S9-Engineering/boreo-superkikko2-torch-mount/LICENSING.md

# S9 Engineering project licensing

Original project designs and documentation are licensed under **Creative Commons Attribution-NonCommercial-ShareAlike 4.0 International (CC BY-NC-SA 4.0)**, to the extent the licensor holds the relevant copyright and similar rights. Original S9 software is separately licensed under **PolyForm Noncommercial License 1.0.0**. This notice identifies the covered material; it does not modify either license. Read the [design/documentation license](LICENSE.txt), its [official summary](https://creativecommons.org/licenses/by-nc-sa/4.0/) and the [software license](LICENSE-SOFTWARE.txt).

## Covered material and attribution

The grant covers original mechanical designs, native CAD documents, design parameters, STEP/STL geometry, the original design content in printable 3MF/G-code, instructions, diagrams and illustrations, unless separately marked. It includes retained revisions and copies of those materials in project release packages. It does not relicense slicer software, profiles or third-party content embedded in these formats. AI-generated illustrations are covered only to the extent the licensor holds applicable rights.

When sharing, credit **S9 Engineering**, link to the source project and license, retain applicable notices and identify changes. Follow the full license for the precise obligations. Suggested credit:

> Based on a design by S9 Engineering — CC BY-NC-SA 4.0. Source: [project repository URL]. Changes: [description, if modified].

Noncommercial copying, printing, adaptation and sharing are permitted within the licensed rights. Shared adaptations must satisfy Section 3(b)'s ShareAlike terms. Private modifications do not have to be published; ShareAlike does not itself require editable CAD source distribution.

## Commercial permissions

The CC BY-NC-SA public license does not grant commercial-use permissions for the designs and documentation. For commercial uses requiring permission under the licensed rights, including selling copies of protected files or protected designs as printed products, contact S9 Engineering for a separate written authorization. No merchant permission, price or automatic approval is granted here.

NonCommercial means not primarily intended for or directed towards commercial advantage or monetary compensation; it is not simply a distinction between individuals and companies. Ask the project maintainer about uncertain uses. This notice adds no restrictions to uses already permitted by the CC license or applicable law.

## S9 names and logos

Standalone S9 / S9 Engineering logo artwork and trademark rights are excluded from the general CC grant. You may retain and reproduce S9 branding already incorporated in a project model or its documentation when printing or sharing that project for permitted noncommercial purposes. Factual attribution and uses allowed by law remain permitted. Other branding uses require separate permission. Do not imply that S9 manufactures, certifies or endorses your copy or adaptation. This branding permission grants no commercial rights or trademark ownership.

## Software and third-party material

Original S9 software files, including executable CAD generators, build/render scripts and project tools, are licensed under **PolyForm Noncommercial License 1.0.0**, including retained original versions, unless a file is separately marked. Read [LICENSE-SOFTWARE.txt](LICENSE-SOFTWARE.txt) for the complete, unmodified terms. These software files are excluded from the CC grant above.

Required Notice: S9 Engineering (https://github.com/S9-Engineering)

When redistributing covered software, include the PolyForm terms or their official URL and retain the Required Notice above and other applicable required notices. The license permits use, modifications and redistribution for its permitted purposes. These include noncommercial and specified personal uses, plus use by the organizations expressly listed in the license, including educational institutions, public research and government institutions, regardless of their funding. Obtain separate permission for software uses outside the public grant; do not treat every professional or institutional use as automatically requiring payment. PolyForm does not impose a requirement to publish modified source code. The software is source-available, not OSI open-source software.

The software license does not automatically determine the license of generated files. Original S9 design content in generated models remains under CC BY-NC-SA 4.0 to the extent covered by the licensed rights. A user's unrelated original output is not automatically relicensed by running a S9 tool.

Third-party software, models, photographs, fonts, libraries, profiles and other assets retain their own rights and notices; they are not relicensed under these S9 defaults. Manufacturer names identify compatibility and do not imply affiliation. This notice grants no rights the licensor does not hold.

## Scope and existing releases

The CC license covers applicable copyright and similar rights only. It creates no rights in purely functional features or public-domain material and licenses no patents or third-party trademarks. It does not guarantee an exclusive right to manufacture a functional object. The software license includes only the patent grant stated in its own terms. With its noncommercial restriction, the project is not offered as open-source hardware under the OSHWA definition.

CC permissions remain available to recipients who comply with their terms. Published archives, tags and checksums are not rewritten when this notice is introduced. Earlier archive instructions saying no license was selected, or that software terms were undecided, describe the position at publication; this notice now grants the stated design/documentation and software rights in covered original material, including copies in those earlier releases. Retain applicable notices and license information when redistributing as required by the respective license. New S9 release packages carry this notice, LICENSE.txt and LICENSE-SOFTWARE.txt.

Separate commercial licensing of other authors' contributions requires their necessary permissions; this notice does not assign their rights to S9 Engineering.
