S9-Engineering/boreo-superkikko2-torch-mount/previews/renders/hero-ai.png

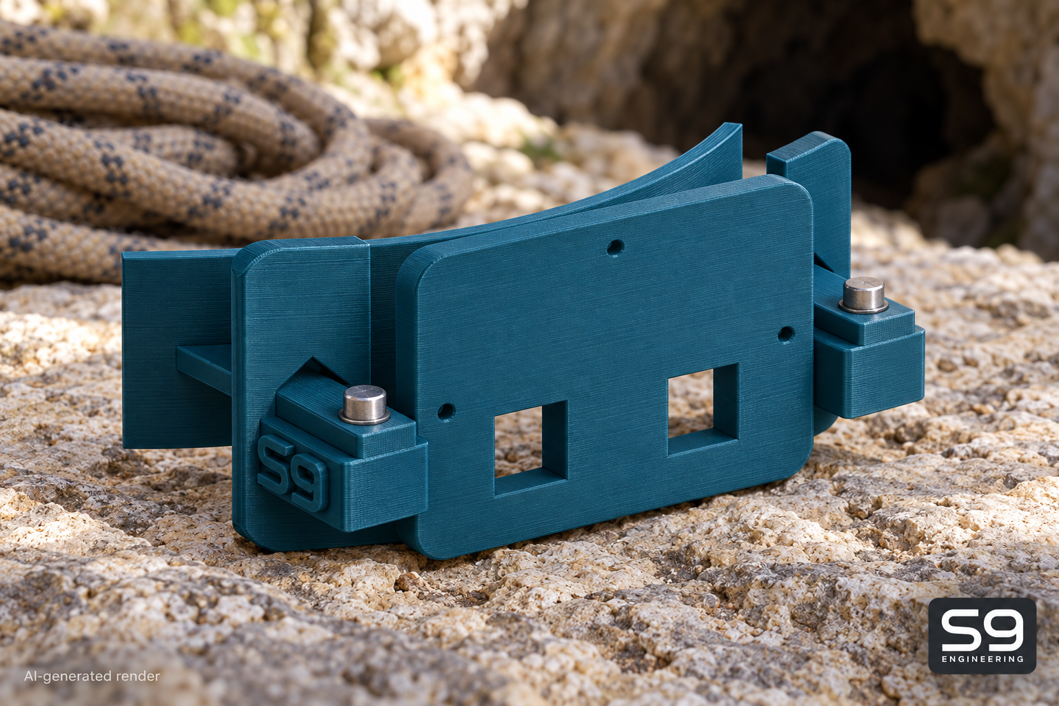
previews/renders/hero-ai.png
