S9-Engineering/boreo-superkikko2-torch-mount/previews/slicing/detail-1.png

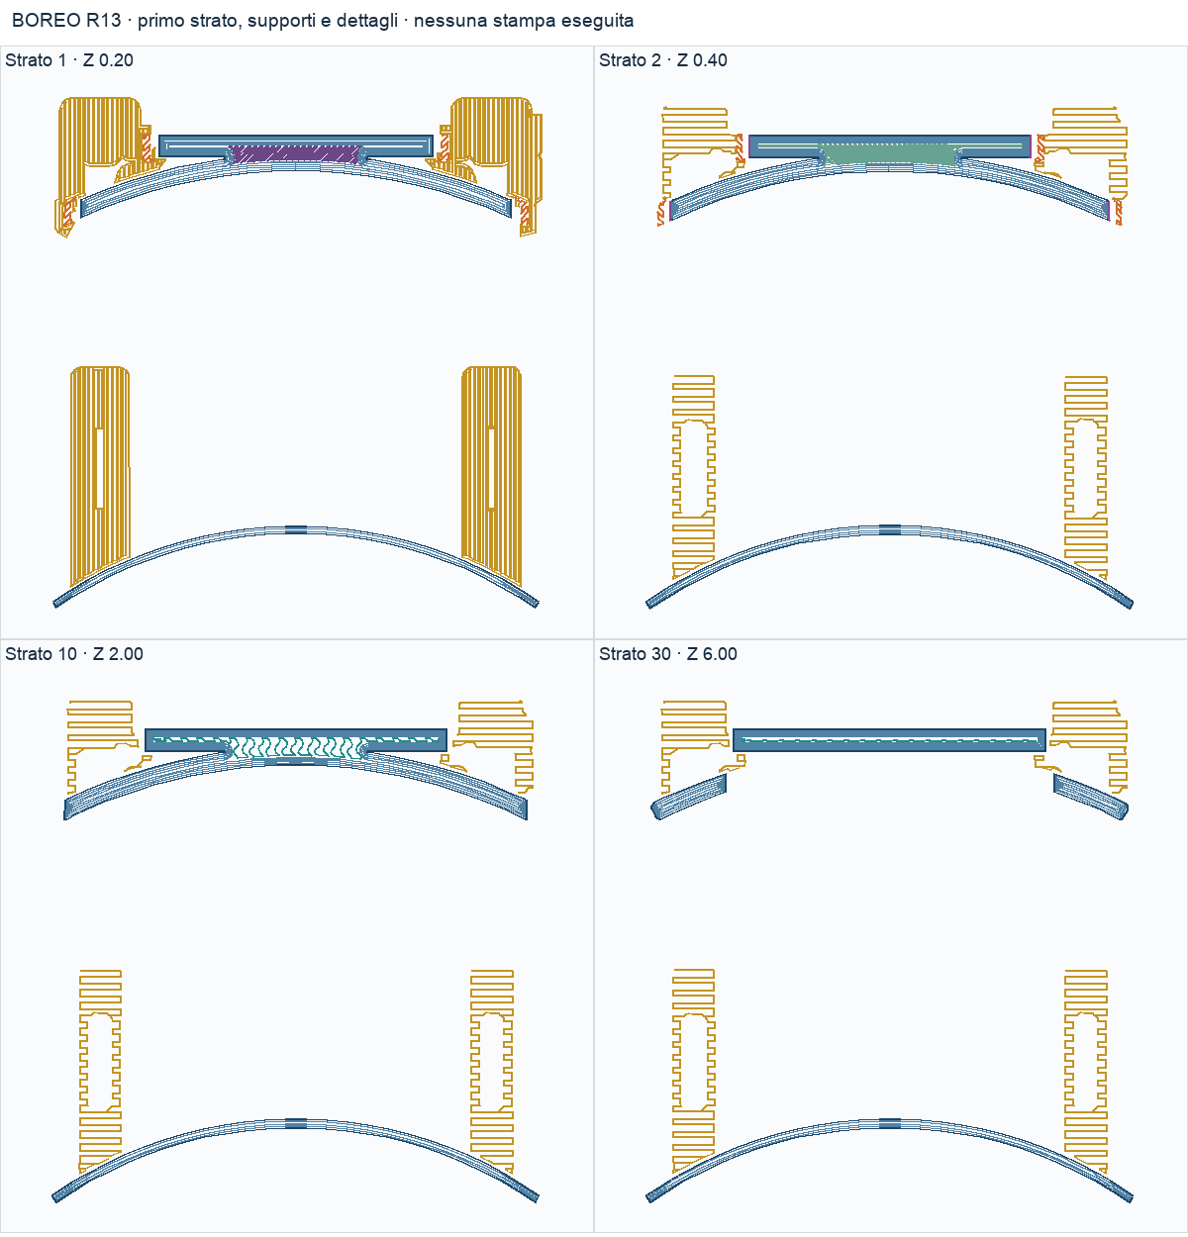
previews/slicing/detail-1.png
