S9-Engineering/boreo-superkikko2-torch-mount/previews/slicing/detail-2.png

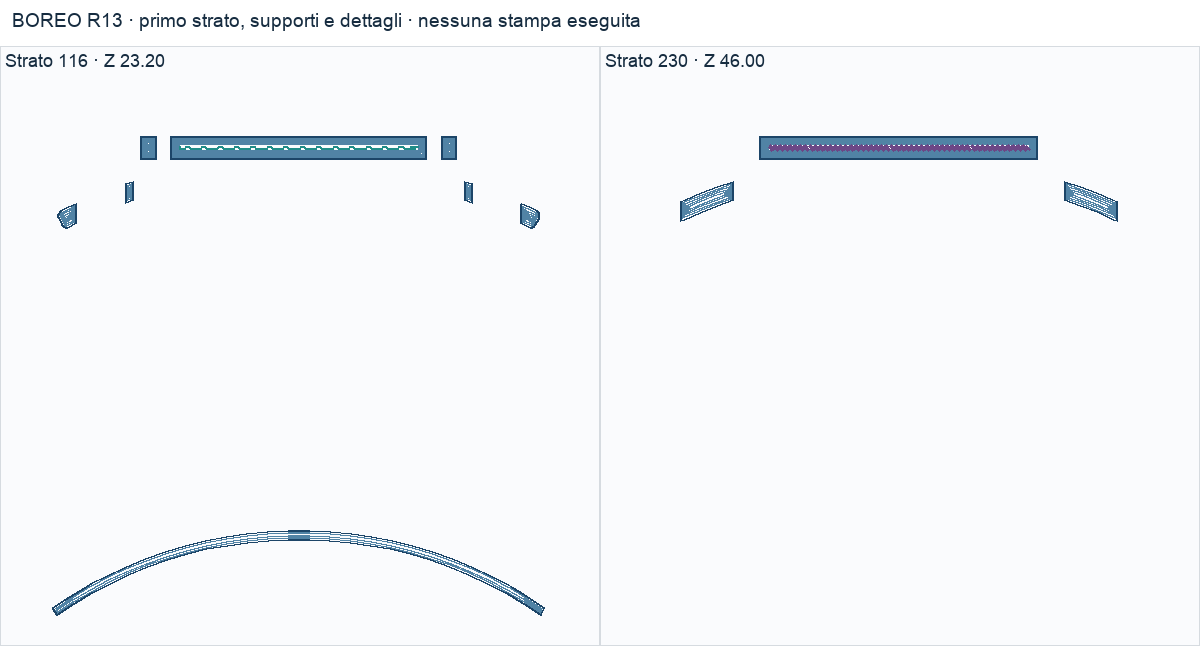
previews/slicing/detail-2.png
