S9-Engineering/boreo-superkikko2-torch-mount/previews/slicing/layers-0001_0064.png

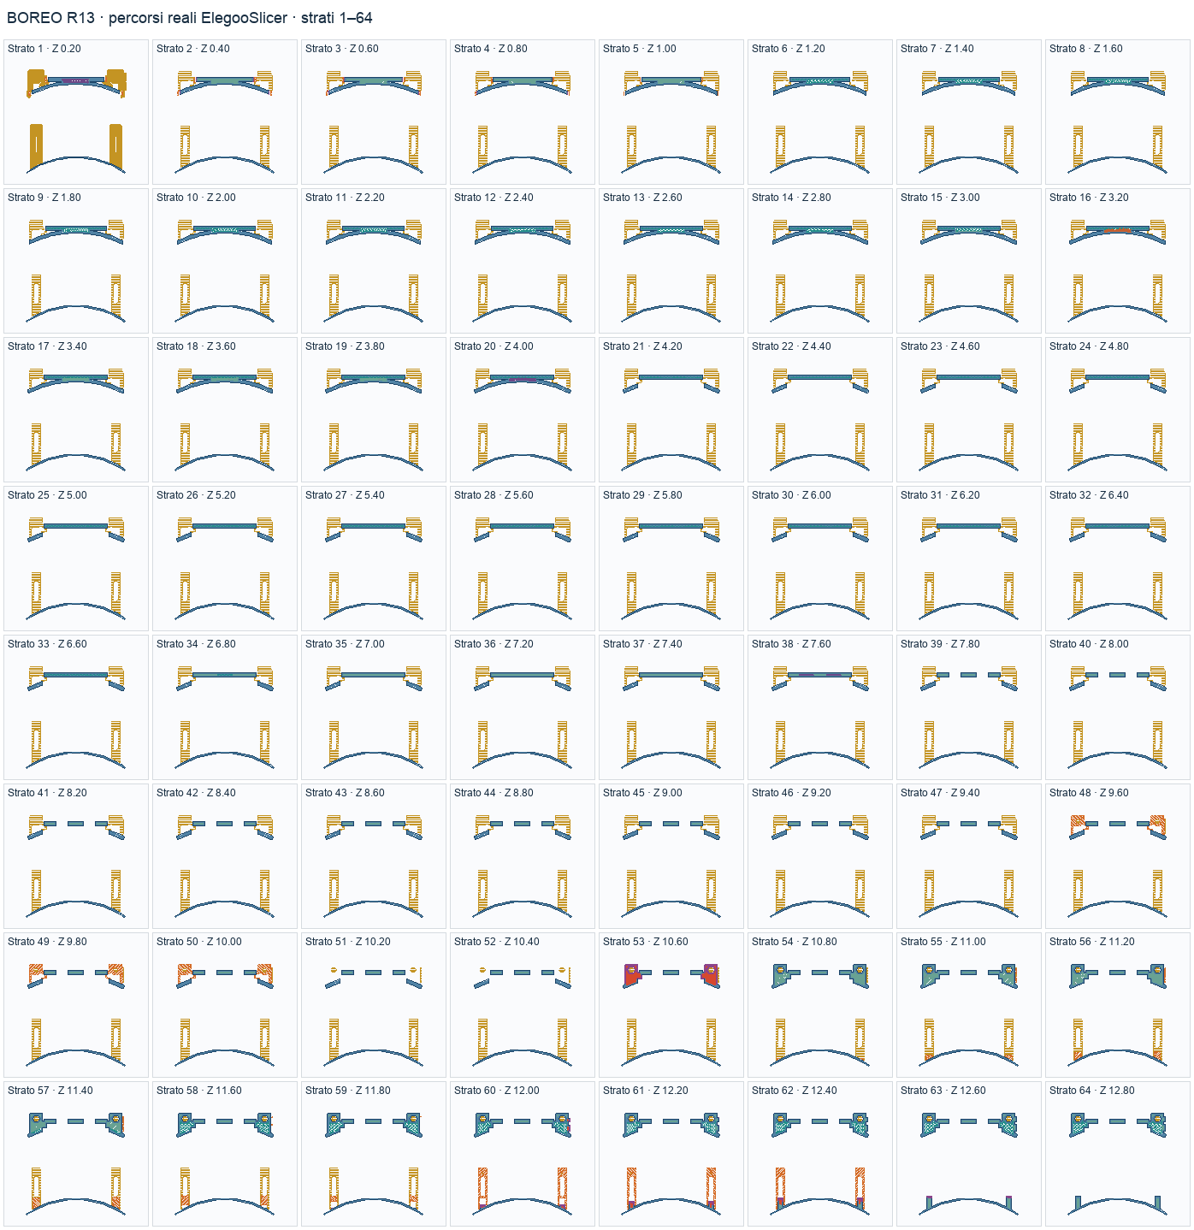
previews/slicing/layers-0001_0064.png
