S9-Engineering/boreo-superkikko2-torch-mount/previews/slicing/layers-0065_0128.png

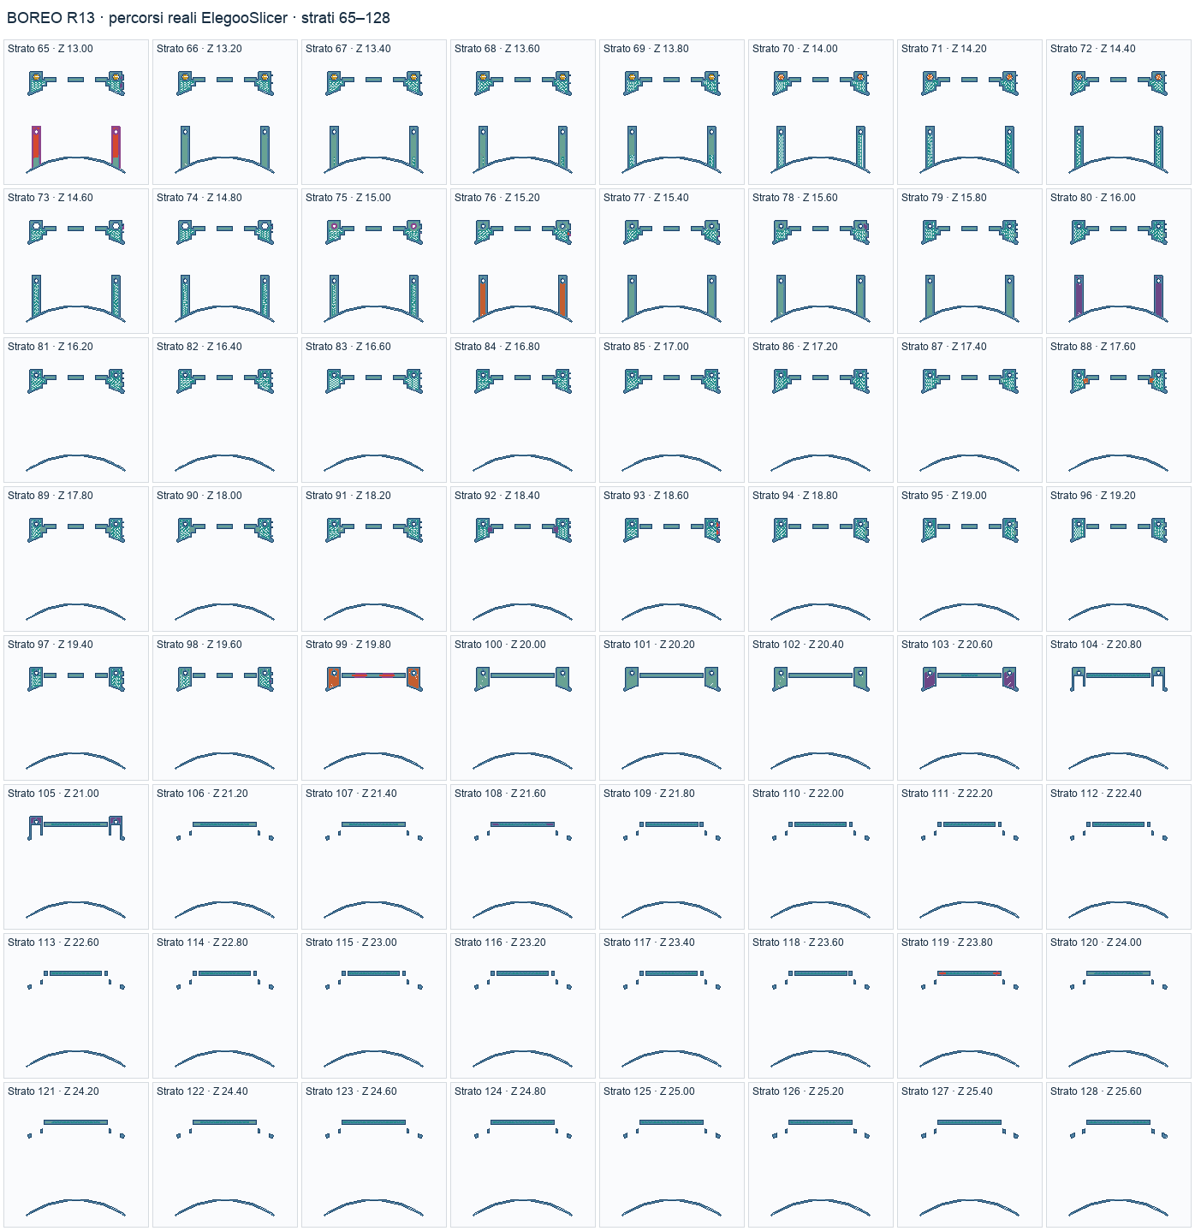
previews/slicing/layers-0065_0128.png
