S9-Engineering/boreo-superkikko2-torch-mount/previews/slicing/layers-0129_0192.png

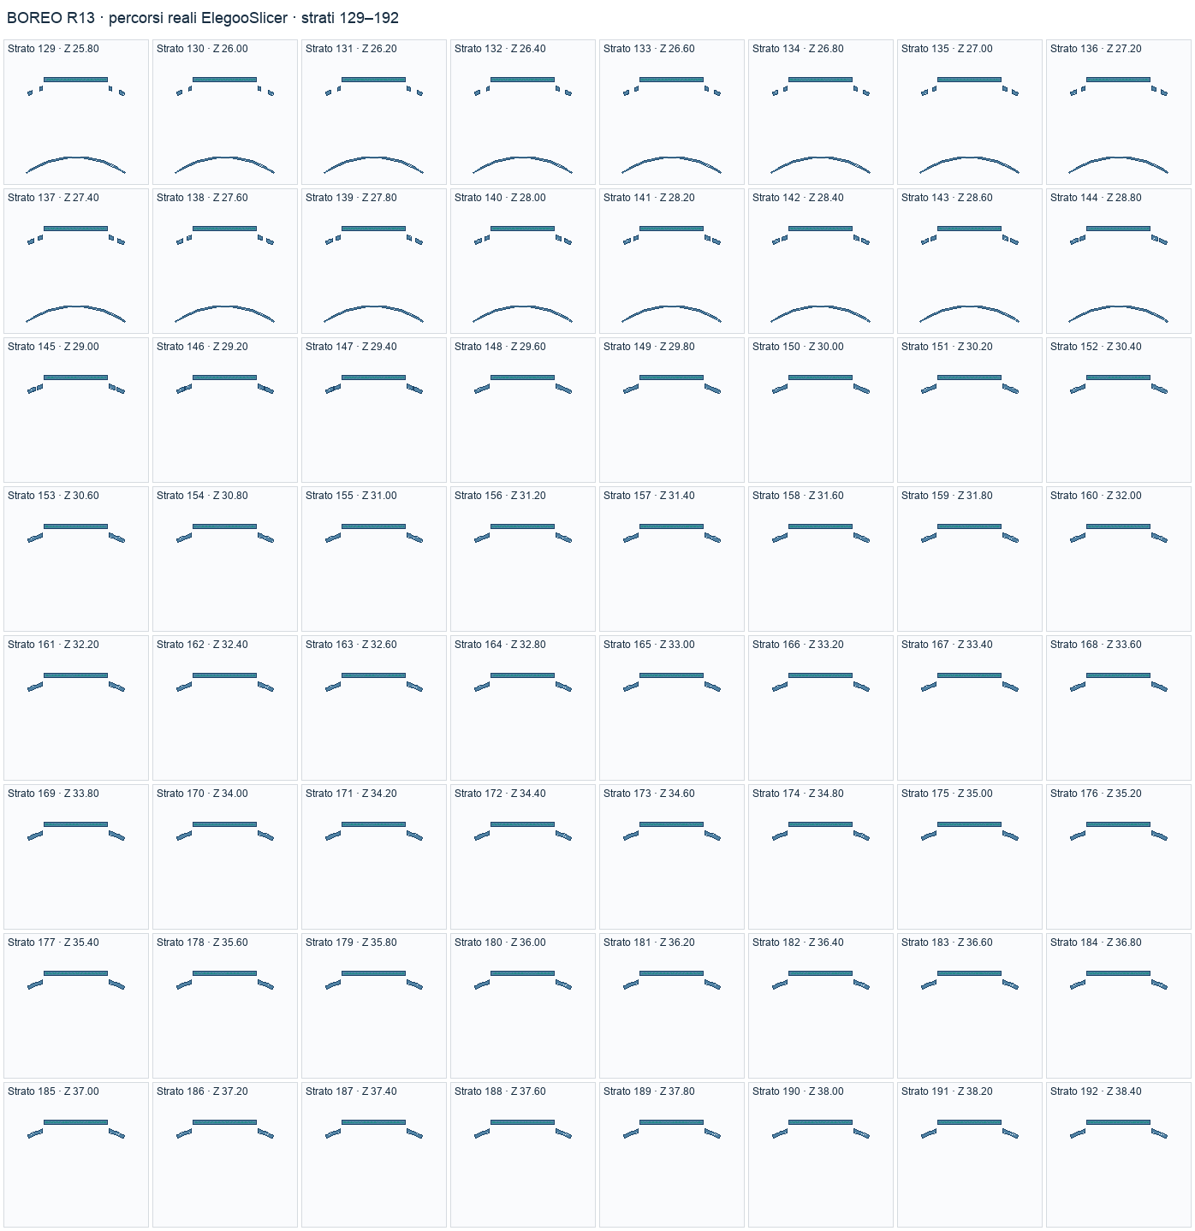
previews/slicing/layers-0129_0192.png
