S9-Engineering/boreo-superkikko2-torch-mount/previews/slicing/layers-0193_0230.png

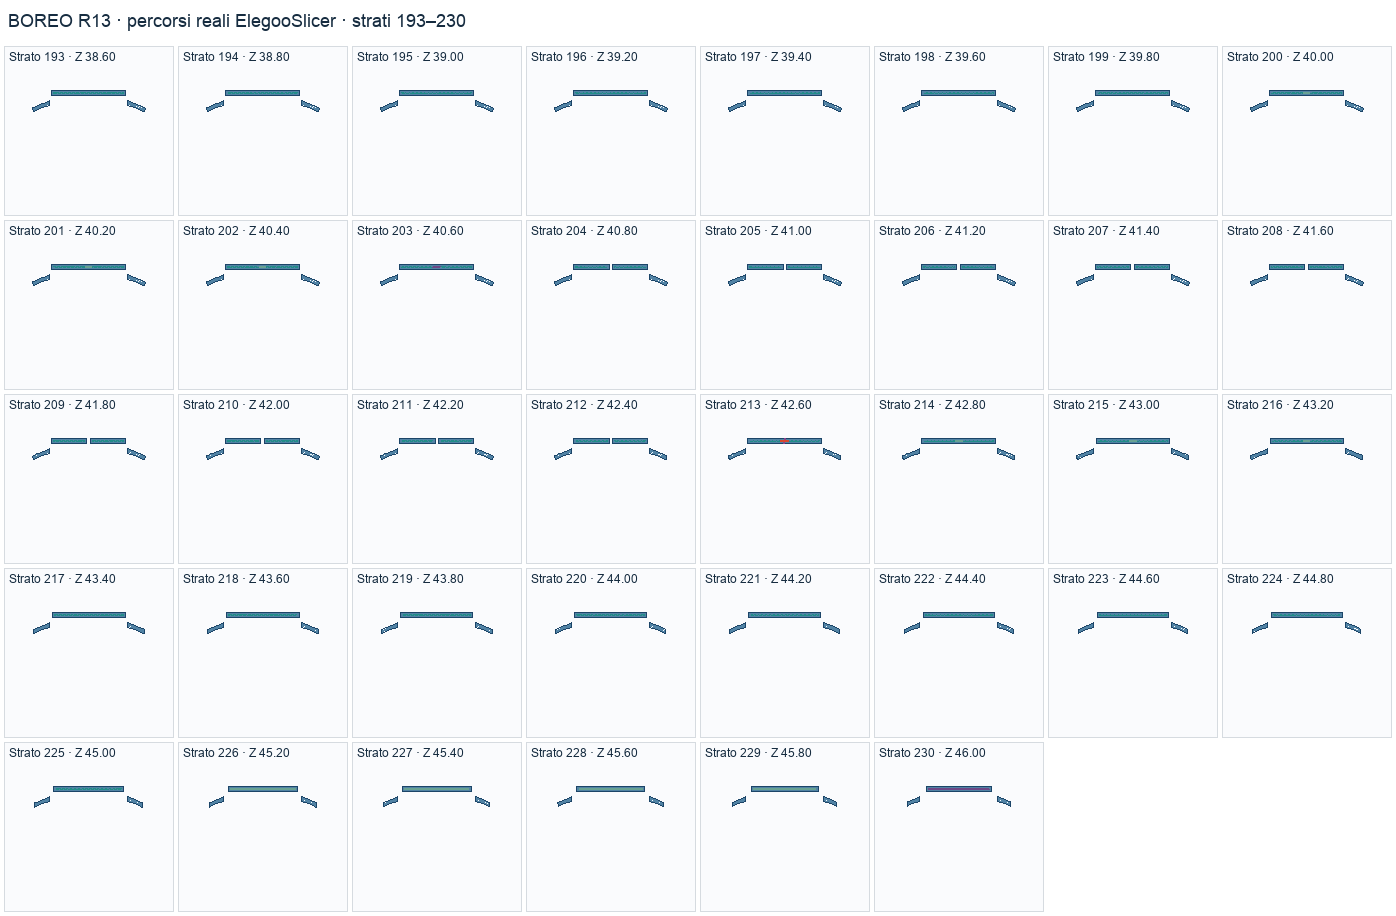
previews/slicing/layers-0193_0230.png
