S9-Engineering/boreo-superkikko2-torch-mount/cad/assembly/assembly-with-hardware.step

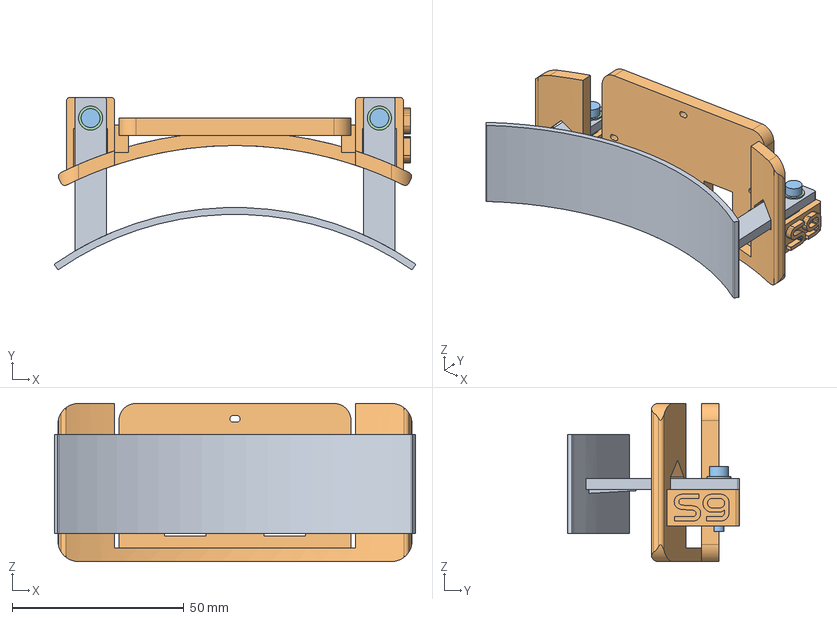
[picture p19: CAD file, 2026-10-25]
cad/assembly/assembly-with-hardware.step
105.0 x 50.0 x 46.0 mm
ponte_centrato
base_appoggi
vite_M3x16_1
rondella_M3_1
dado_autobloccante_M3_1
vite_M3x16_2
rondella_M3_2
dado_autobloccante_M3_2
