S9-Engineering/boreo-superkikko2-torch-mount/cad/assembly/assembly.step

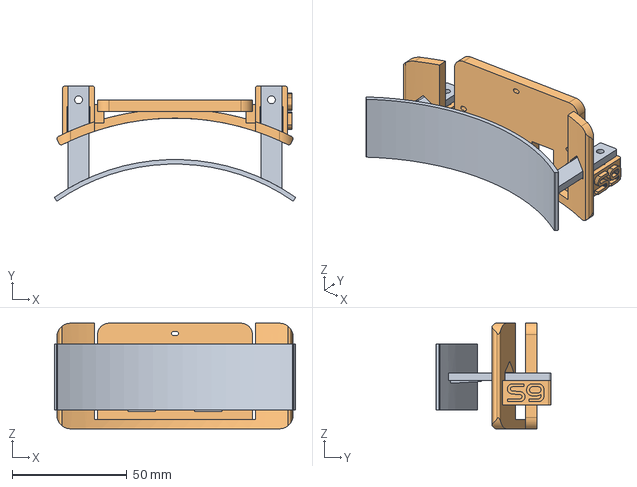
[picture p20: CAD file, 2026-10-25]
cad/assembly/assembly.step
105.0 x 50.0 x 46.0 mm
ponte_centrato
base_appoggi
