S9-Engineering/boreo-superkikko2-torch-mount/cad/inner-bridge.step

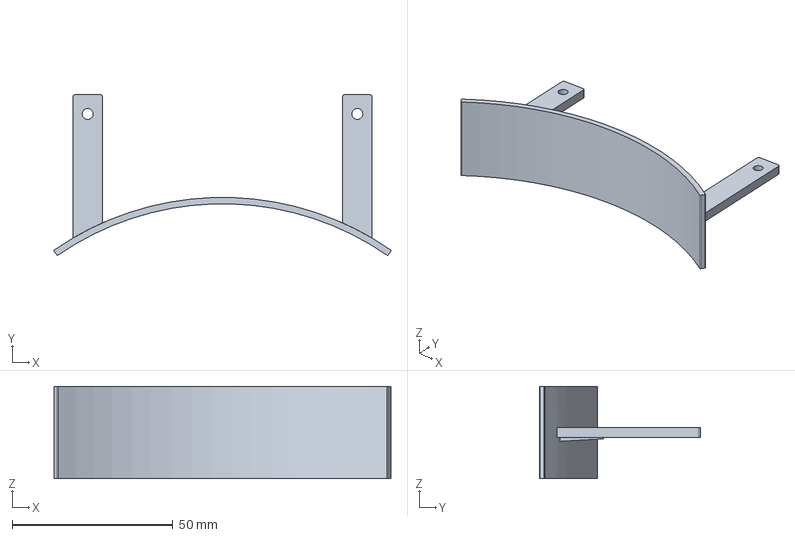
[picture p21: CAD file, 2026-10-25]
cad/inner-bridge.step
105.0 x 50.0 x 28.8 mm
