S9-Engineering/boreo-superkikko2-torch-mount/print/slicer/geometry-only.3mf

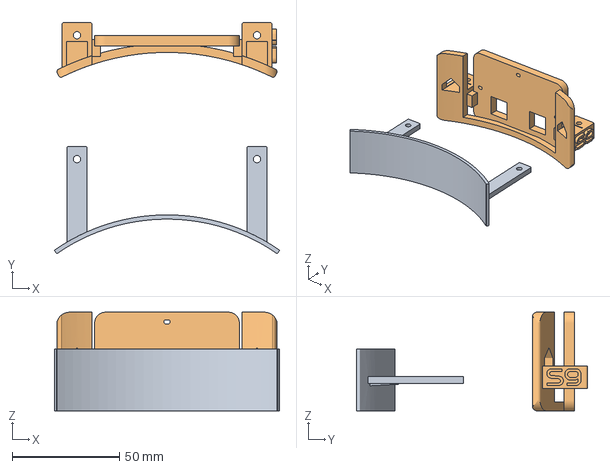
[picture p22: CAD file, 2026-10-25]
print/slicer/geometry-only.3mf
105.0 x 107.8 x 46.0 mm
ponte_centrato
base_appoggi
