S9-Engineering/boreo-superkikko2-torch-mount/cad/backing-plate.step

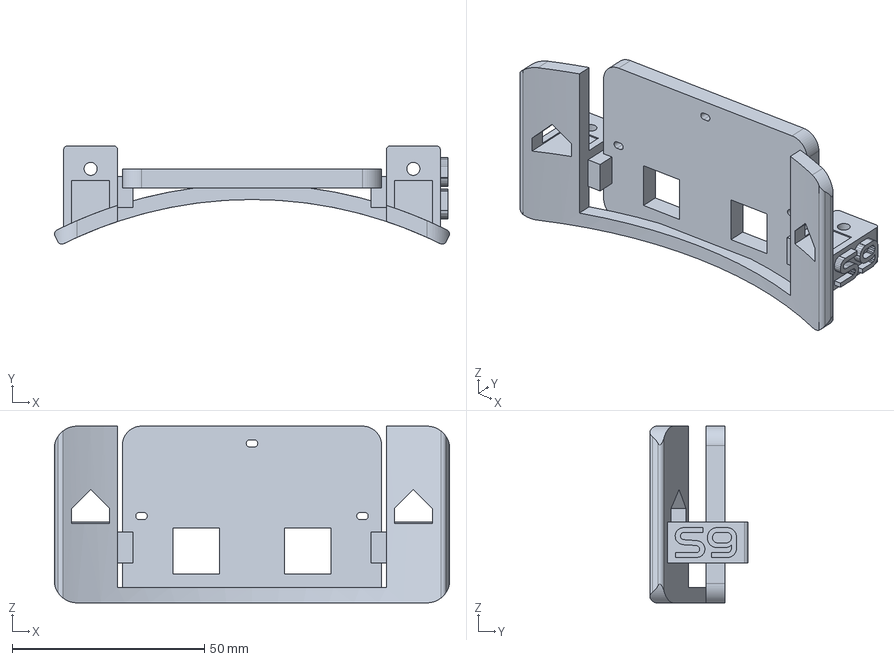
[picture p23: CAD file, 2026-10-25]
cad/backing-plate.step
102.8 x 25.6 x 46.0 mm
