S9-Engineering/boreo-superkikko2-torch-mount/cad/reference/frame-reference.step

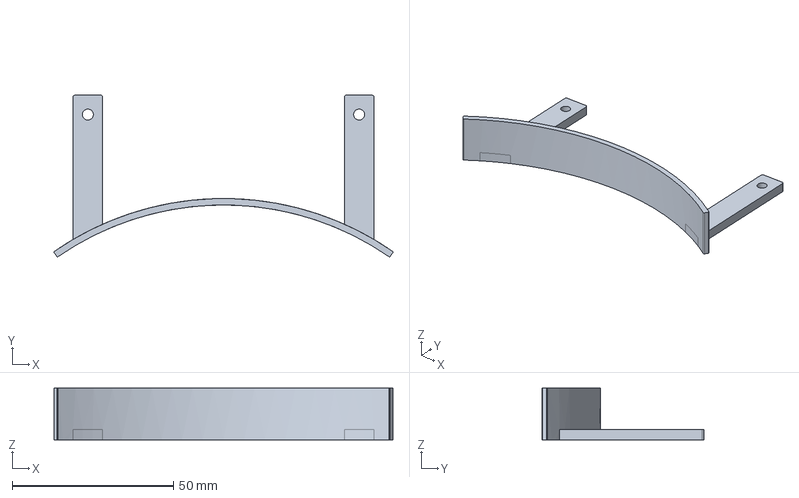
[picture p24: CAD file, 2026-10-25]
cad/reference/frame-reference.step
105.0 x 50.0 x 16.0 mm
