S9-Engineering/boreo-superkikko2-torch-mount/cad/hardware/nut-m3-1.step

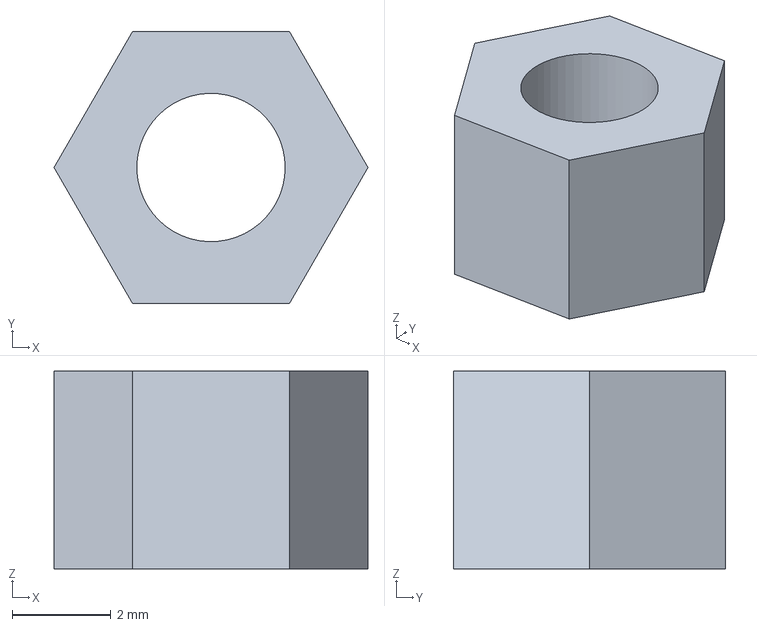
[picture p25: CAD file, 2026-10-25]
cad/hardware/nut-m3-1.step
6.35 x 5.50 x 4.00 mm
