S9-Engineering/boreo-superkikko2-torch-mount/cad/hardware/screw-m3x16-2.step

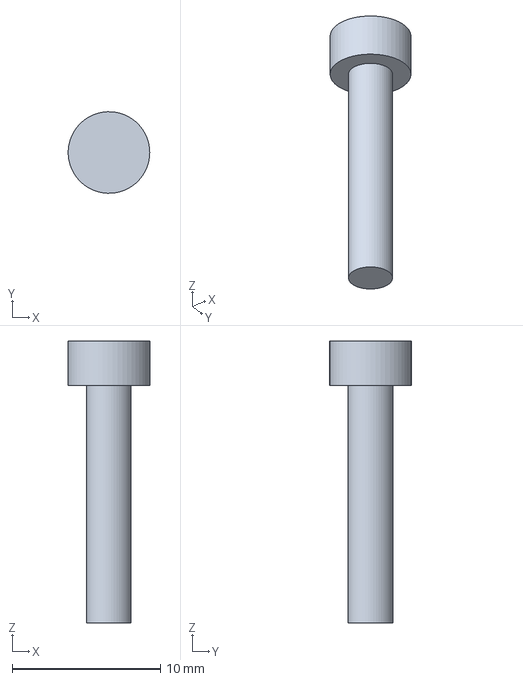
[picture p26: CAD file, 2026-10-25]
cad/hardware/screw-m3x16-2.step
5.49 x 5.50 x 19.0 mm
