S9-Engineering/boreo-superkikko2-torch-mount/cad/hardware/washer-m3-1.step

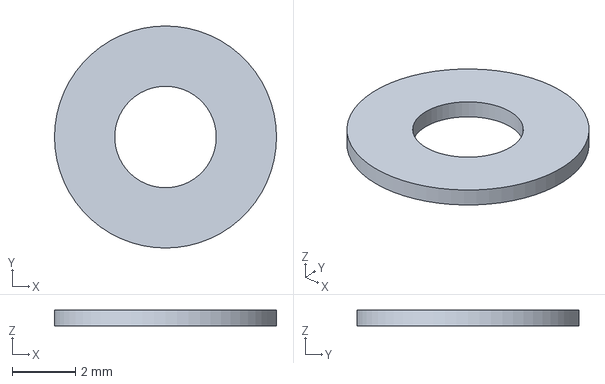
[picture p27: CAD file, 2026-10-25]
cad/hardware/washer-m3-1.step
7.00 x 7.00 x 0.5 mm
