S9-Engineering/boreo-superkikko2-torch-mount/(list of files, cad)

Other CAD files:
cad/reference/inner-bridge-reference.step
cad/reference/backing-plate-reference.step
print/slicer/boreo-superkikko2-petg.3mf
cad/assembly/inner-bridge.step
cad/assembly/backing-plate.step
cad/hardware/nut-m3-2.step
cad/hardware/screw-m3x16-1.step
cad/hardware/washer-m3-2.step
cad/assembly/backing-plate.stl
cad/assembly/inner-bridge.stl
cad/hardware/nut-m3-1.stl
cad/hardware/nut-m3-2.stl
cad/hardware/screw-m3x16-1.stl
cad/hardware/screw-m3x16-2.stl
cad/hardware/washer-m3-1.stl
cad/hardware/washer-m3-2.stl
print/stl/backing-plate.stl
print/stl/inner-bridge.stl
