S9-Engineering/boreo-superkikko2-torch-mount/assets/measurements/2026-10-16-feritoie-spessore.jpg

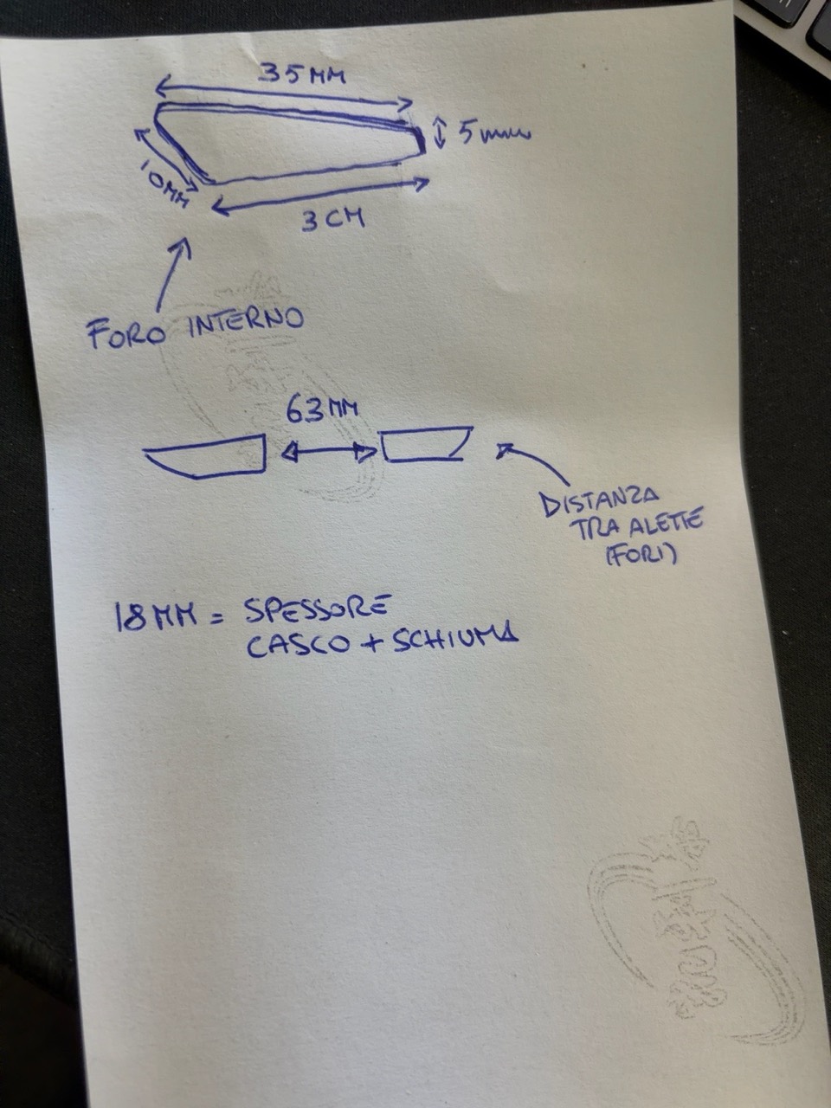
assets/measurements/2026-10-16-feritoie-spessore.jpg
