S9-Engineering/boreo-superkikko2-torch-mount/assets/measurements/helmet-1.jpg

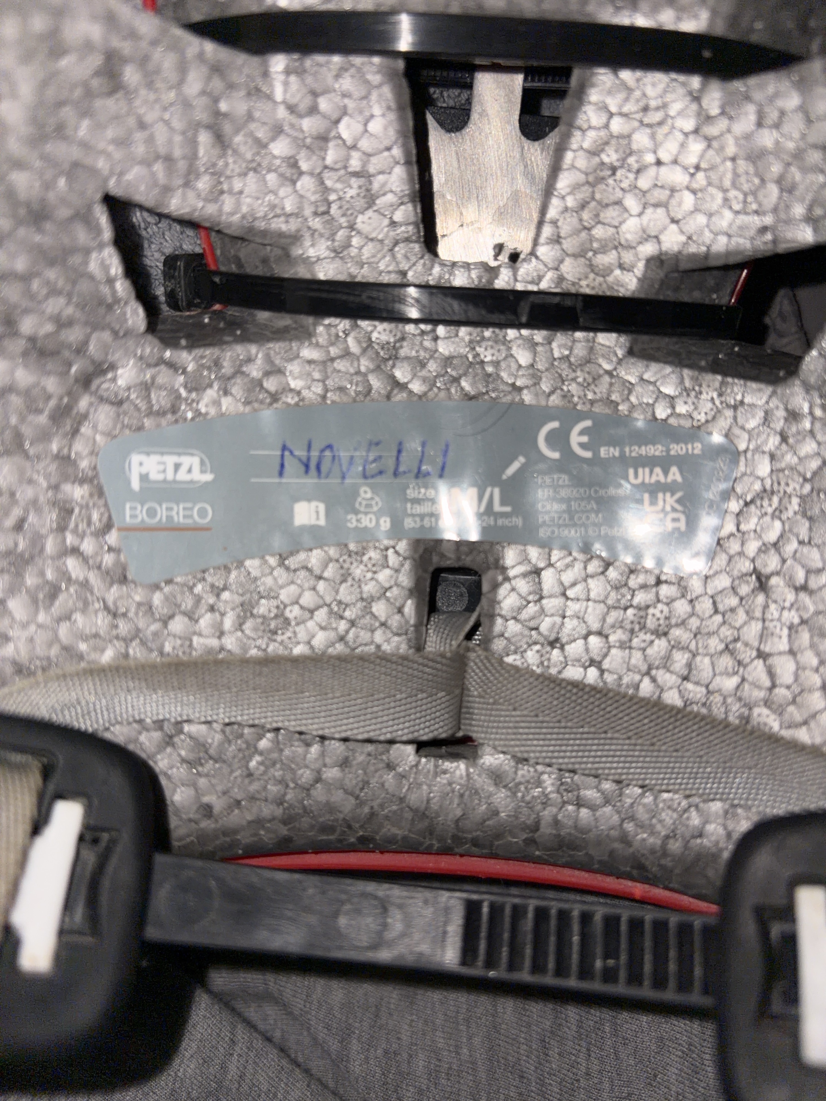
assets/measurements/helmet-1.jpg
