S9-Engineering/boreo-superkikko2-torch-mount/assets/measurements/helmet-2.jpg

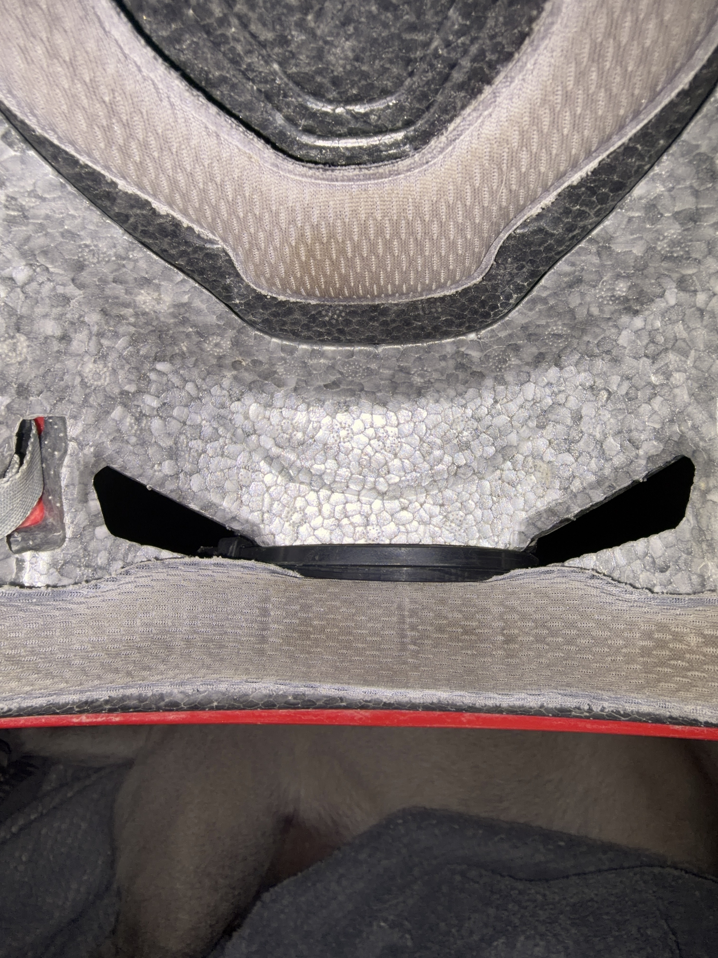
assets/measurements/helmet-2.jpg
