S9-Engineering/boreo-superkikko2-torch-mount/assets/measurements/helmet-4.jpg

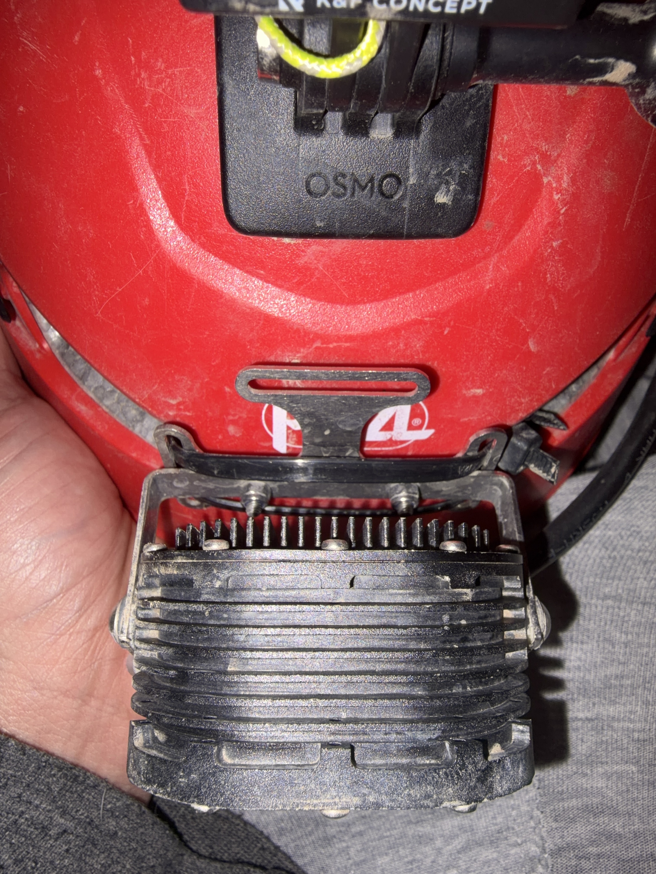
assets/measurements/helmet-4.jpg
