S9-Engineering/boreo-superkikko2-torch-mount/(commit log)

2026-10-25 Prepare BOREO Superkikko2 R13 PETG prototype and print package
    [BASE_R10_STAMPA.step, BOREO_R05_DIMA_PLA_BASIC_ECC2_04.3mf, BOREO_R06_DIMA_PLA_BASIC_ECC2_04.3mf, BOREO_R07_DIMA_PLA_BASIC_ECC2_04.3mf, BOREO_R07_PROVINO_GIUNTO_PLA_ECC2_04.3mf, BOREO_R08_A_DIMA_PLA_BASIC_ECC2_04.3mf, BOREO_R08_B_BASE_PONTE_PLA_BASIC_ECC2_04.3mf, BOREO_R09_A_DIMA_PLA_BASIC_ECC2_04.3mf]
2026-10-25 Use stable English project paths and Git history for versioning
    [BASE_R10_STAMPA.step, BOREO_R05_DIMA_PLA_BASIC_ECC2_04.3mf, BOREO_R06_DIMA_PLA_BASIC_ECC2_04.3mf, BOREO_R07_DIMA_PLA_BASIC_ECC2_04.3mf, BOREO_R07_PROVINO_GIUNTO_PLA_ECC2_04.3mf, BOREO_R08_A_DIMA_PLA_BASIC_ECC2_04.3mf, BOREO_R08_B_BASE_PONTE_PLA_BASIC_ECC2_04.3mf, BOREO_R09_A_DIMA_PLA_BASIC_ECC2_04.3mf]
2026-10-25 Normalize CAD utility source formatting
2026-10-27 Document real PLA mount photos and prepare publication assets
2026-10-27 Correct photographed mount material to PETG
